hackerspace-ntnu/Coglight-badge-THT/Documentation/Figures/Pinout.png

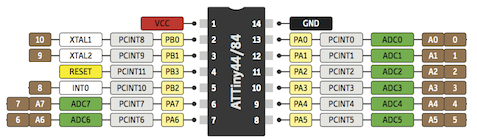
Documentation/Figures/Pinout.png
