hackerspace-ntnu/Coglight-badge-THT/Documentation/Figures/Finished.png

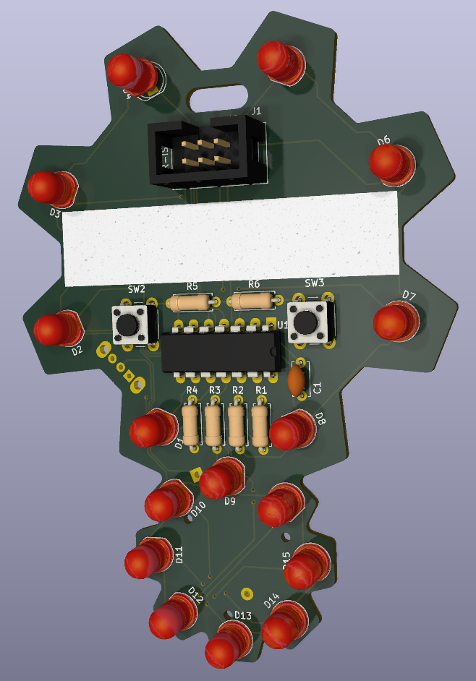
Documentation/Figures/Finished.png
