hackerspace-ntnu/Coglight-badge-THT/Documentation/Figures/Matrix.png

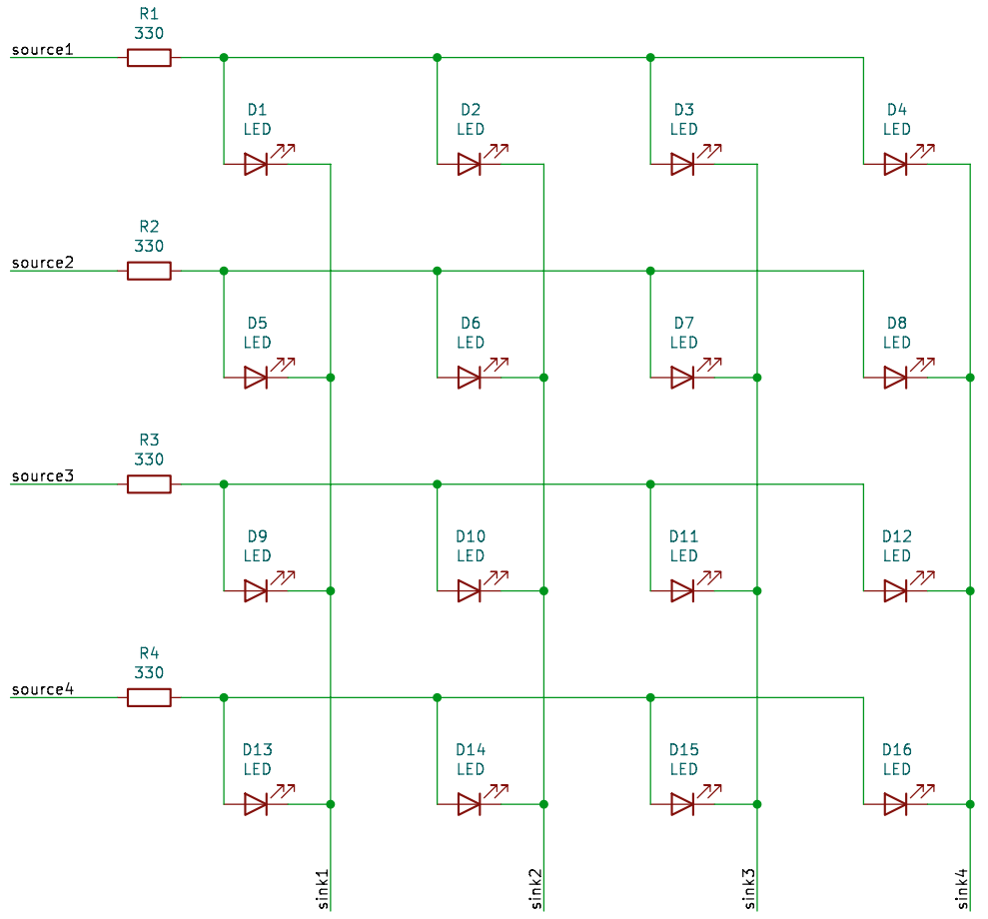
Documentation/Figures/Matrix.png
