hackerspace-ntnu/Coglight-badge-THT/Documentation/Figures/CogLightBadgeTHT.pdf

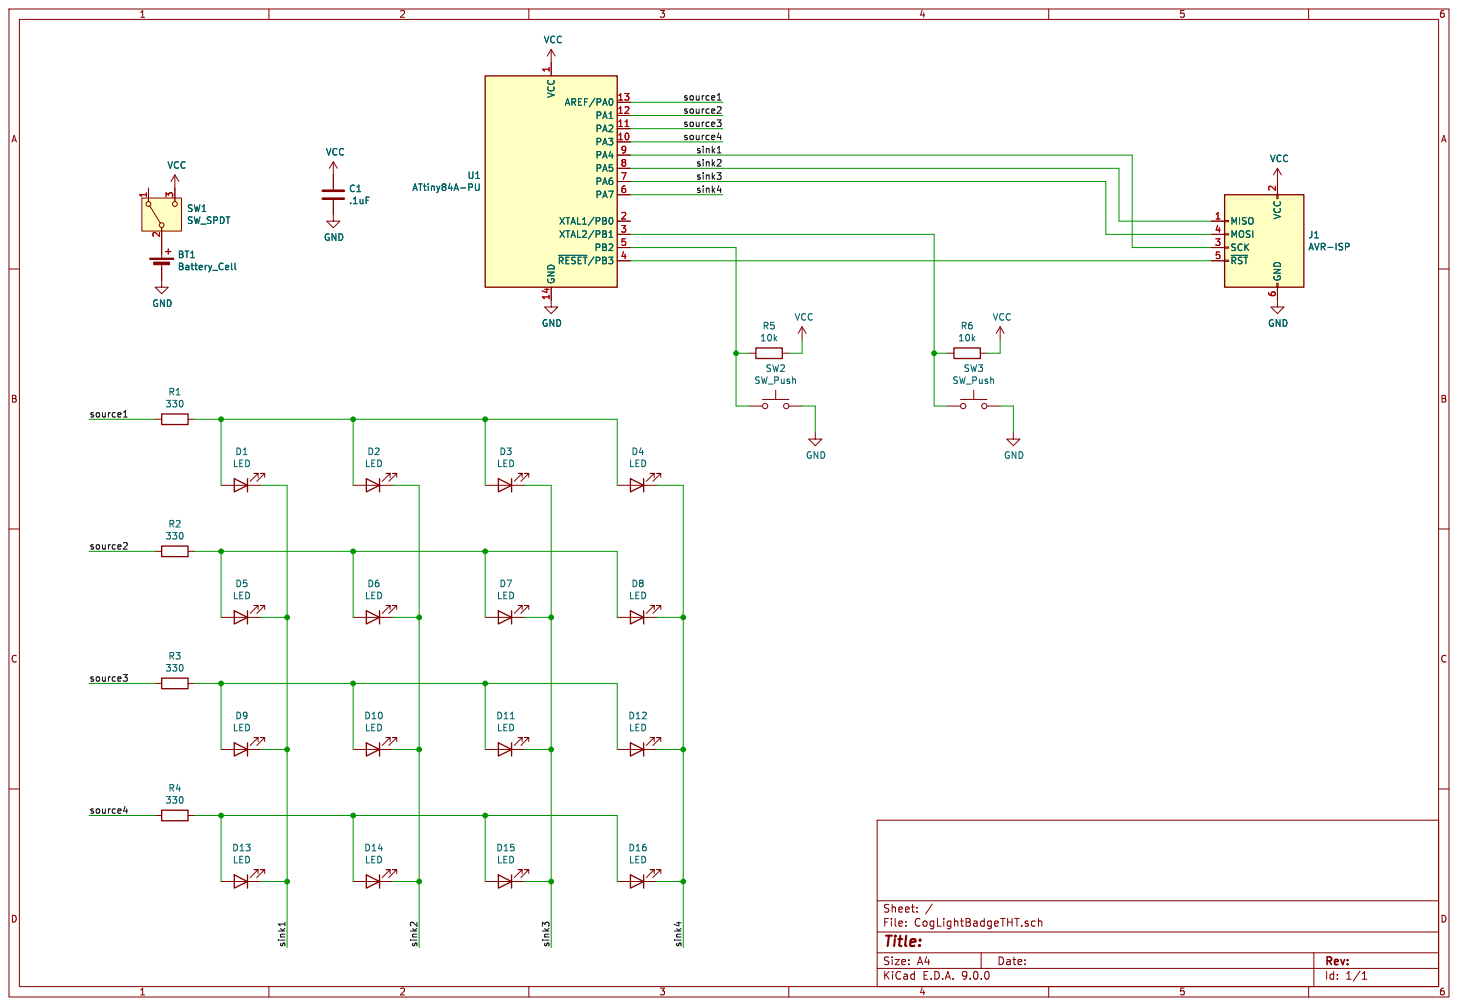
[picture p4: page 1]

1 GND 14 AREF/PA0 13 PA1 12 PA2 11 PA3 10 PA4 9 PA5 8 PA6 7 PA7 6 XTAL1/PB0 2 XTAL2/PB1 3 PB2 5 ~{RESET}/PB34 VCC GND

1 GND 14 AREF/PA0 13 PA1 12 PA2 11 PA3 10 PA4 9 PA5 8 PA6 7 PA7 6 XTAL1/PB0 2 XTAL2/PB1 3 PB2 5 ~{RESET}/PB34 U1 ATtiny84A-PU

6 MISO 1 MOSI 4 SCK 3 ~{RST} 5 VCC

6 MISO 1 MOSI 4 SCK 3 ~{RST} 5

Id: 1/1 Title: File: CogLightBadgeTHT.sch Sheet: /
