hackerspace-ntnu/Coglight-badge-THT/KiCad/CogLightBadgeTHT.kicad_pcb

## KiCad design KiCad/CogLightBadgeTHT.kicad_pcb (2025-02-27)

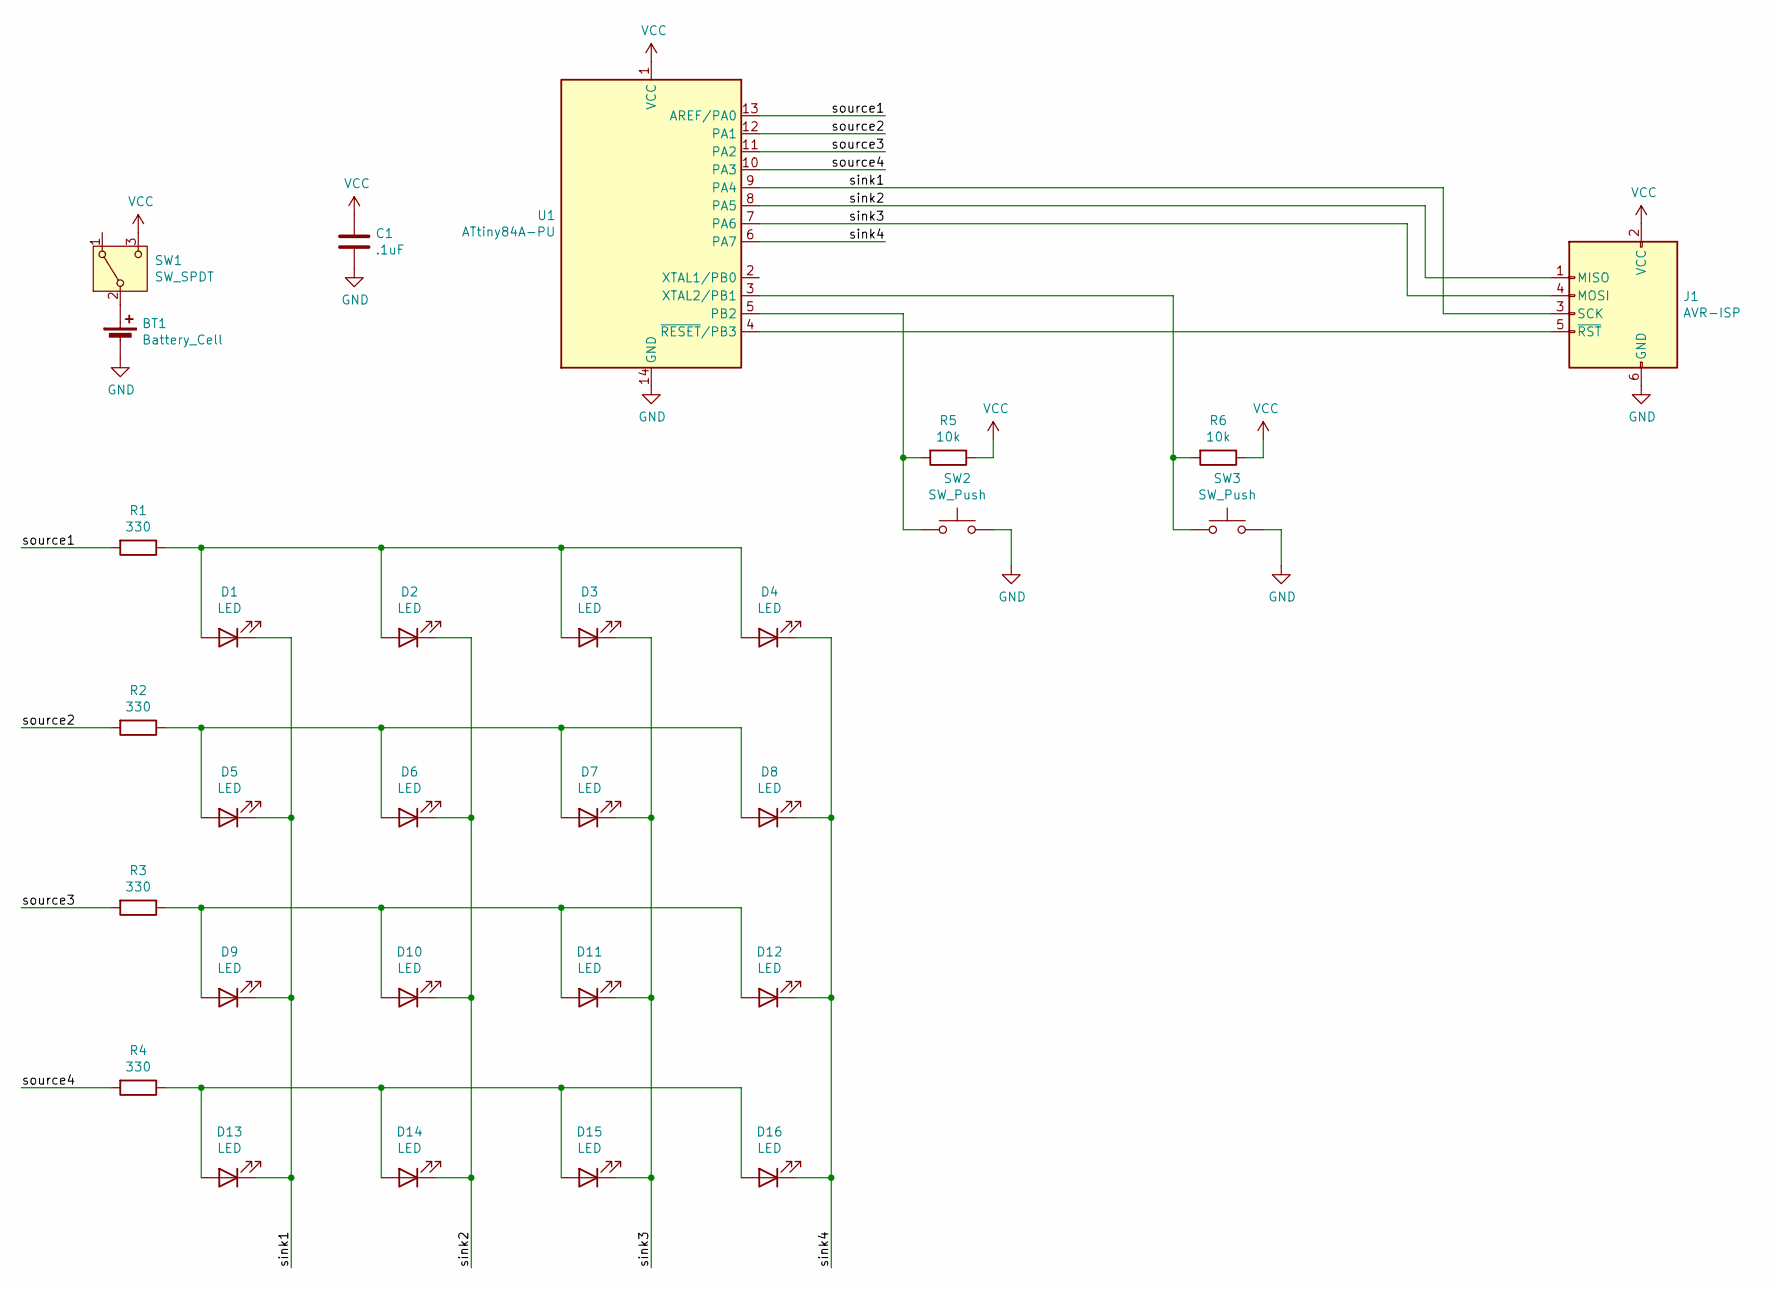
[picture p5: schematic CogLightBadgeTHT.kicad_sch]

Parts:
BT1: Battery_Cell; MP000362_CR2032_Holder_THT
C1: .1uF; C_Disc_D5.0mm_W2.5mm_P5.00mm
D1, D2, D3, D4, D5, D6, D7, D8, D9, D10, D11, D12, D13, D14, D15, D16: LED; LED_D5.0mm
J1: AVR-ISP; IDC-Header_2x03_P2.54mm_Vertical
R1, R2, R3, R4: 330; R_Axial_DIN0207_L6.3mm_D2.5mm_P7.62mm_Horizontal
R5, R6: 10k; R_Axial_DIN0207_L6.3mm_D2.5mm_P7.62mm_Horizontal
SW1: SW_SPDT; OS102011MA1QN1_SPDT_SlideSwithch_THT
SW2, SW3: SW_Push; SW_PUSH_6mm_H5mm
U1: ATtiny84A-PU; DIP-14_W7.62mm_LongPads

Connections:
/sink1: D1.1 (K), D5.1 (K), D9.1 (K), D13.1 (K), J1.3 (SCK), U1.9 (PA4)
/sink2: D2.1 (K), D6.1 (K), D10.1 (K), D14.1 (K), J1.1 (MISO), U1.8 (PA5)
/sink3: D3.1 (K), D7.1 (K), D11.1 (K), D15.1 (K), J1.4 (MOSI), U1.7 (PA6)
/sink4: D4.1 (K), D8.1 (K), D12.1 (K), D16.1 (K), U1.6 (PA7)
/source1: R1.2, U1.13 (AREF/PA0)
/source2: R2.2, U1.12 (PA1)
/source3: R3.2, U1.11 (PA2)
/source4: R4.2, U1.10 (PA3)
GND: BT1.2 (-), C1.2, J1.6 (GND), SW2.2, SW3.2, U1.14 (GND)
unnamed: BT1.1 (+), SW1.2 (B)
unnamed: D1.2 (A), D2.2 (A), D3.2 (A), D4.2 (A), R1.1
unnamed: D5.2 (A), D6.2 (A), D7.2 (A), D8.2 (A), R2.1
unnamed: D9.2 (A), D10.2 (A), D11.2 (A), D12.2 (A), R3.1
unnamed: D13.2 (A), D14.2 (A), D15.2 (A), D16.2 (A), R4.1
unnamed: J1.5 (~RST), U1.4 (~RESET/PB3)
unnamed: R5.2, SW2.1, U1.5 (PB2)
unnamed: R6.2, SW3.1, U1.3 (XTAL2/PB1)
VCC: C1.1, J1.2 (VCC), R5.1, R6.1, SW1.3 (C), U1.1 (VCC)

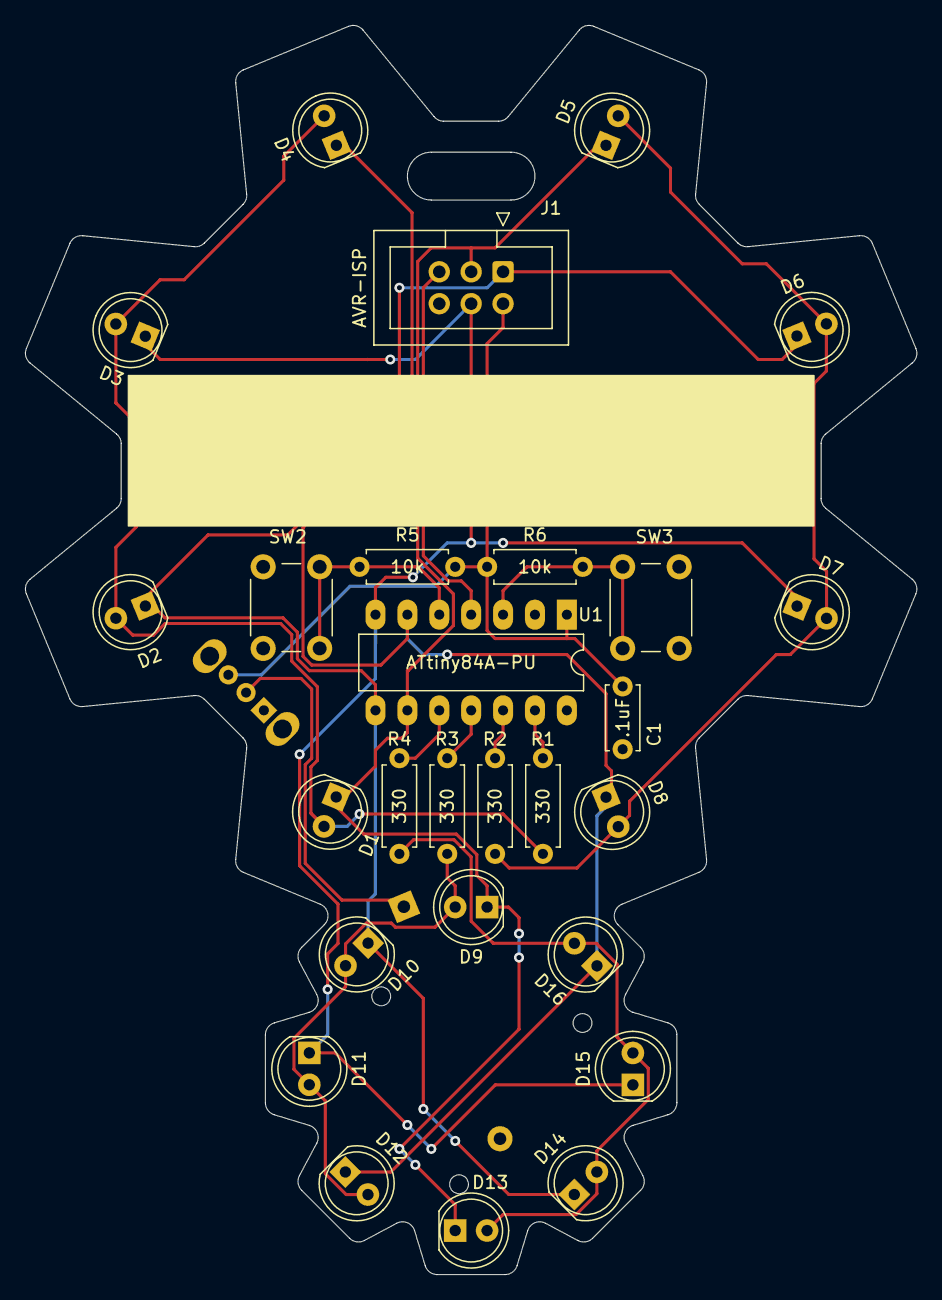
[picture p6: board CogLightBadgeTHT.kicad_pcb from above]

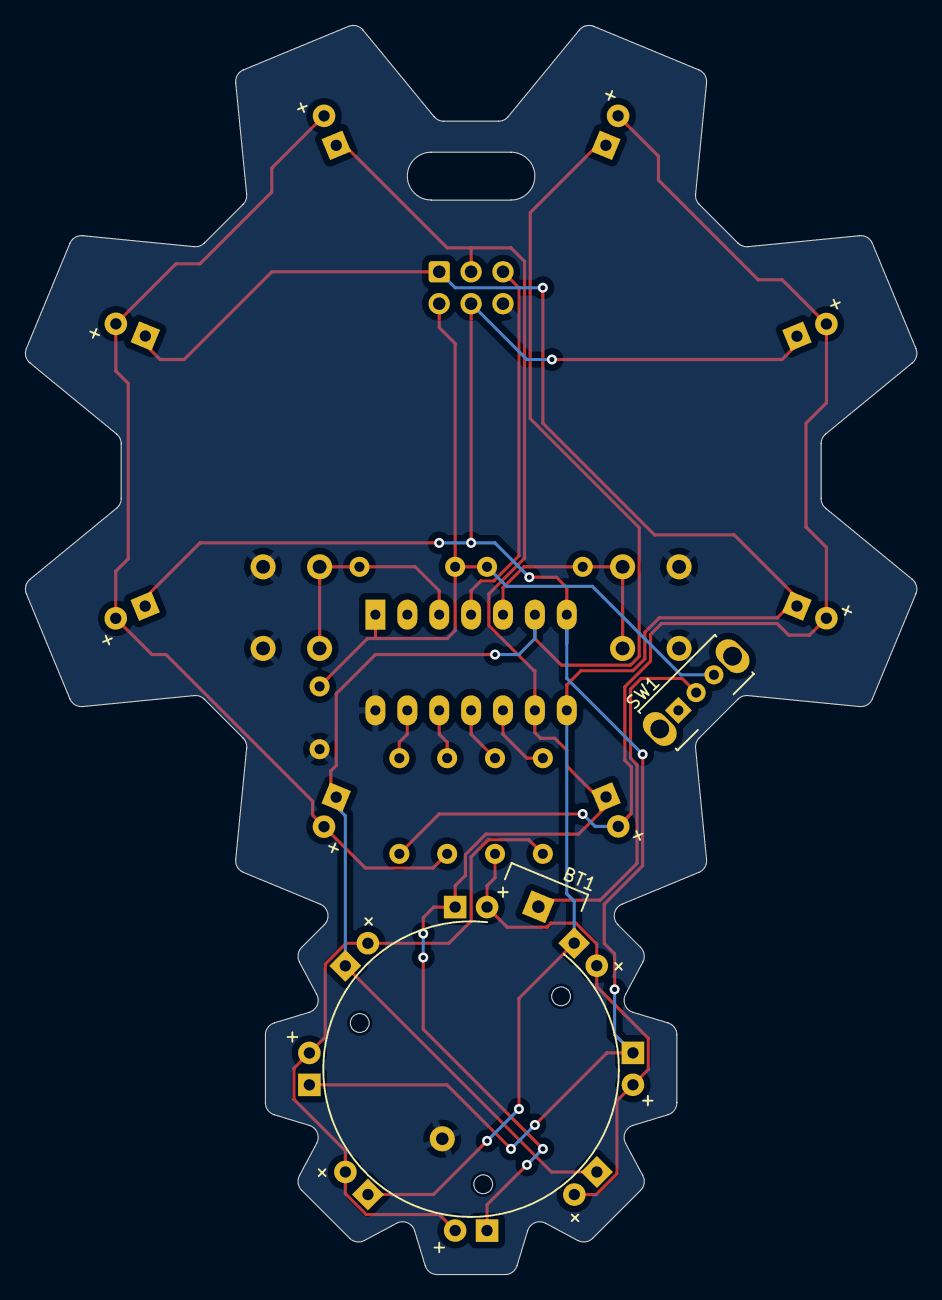
[picture p7: board CogLightBadgeTHT.kicad_pcb from below]

Board: 2 copper layers, 71.0 x 99.5 mm, 29 parts (2 on the bottom side), 18 nets.
