hackerspace-ntnu/Coglight-badge-THT/Firmware/CogBadgeArduino/CogBadgeArduino.ino

/*
 * CogBadge THT
 *
 * Original author: Benjamin
 * Adapted for Arduino IDE: Robin Pfeifer
 */ 
 

void setup() {
  DDRA = 0b11111111;	
}

//=================================//
//   Patterns                      //
//=================================//

// Pattern struct
typedef struct {
  uint8_t size; // Number of stages to the pattern to cycle through
  uint8_t stages[16]; // Patterns may have a maximum of 16 stages
} Pattern;

// Create patterns
/* See CogLightBadgeTHT.pdf for schematics. The pins read from right to left 
(source1 is farthest to the right, sink4 is farthest to the left after the b)
The sources and sinks form a matrix, where the source and sink value for each LED
combines to give the LED's value. 0 corresponds to OFF, 1 corresponds to ON. 
For example, if source1 and sink1 are both 1, D1 is 0, 
while if source1 is 1 and sink1 is 0, D1 is 1.
*/
#define patternsSIZE 9
Pattern patterns[patternsSIZE] = {
  { // Counter-clockwise 4 on at a time
    .size = 4,
    .stages = {
    0b01111111,
    0b10111111,
    0b11011111,
    0b11101111
    }
  },
  { // Clockwise 4 on at a time
	  .size = 4,
	  .stages = {
		0b01111111,
		0b11101111,
		0b11011111,
		0b10111111
	  }
  },
  { // Counter-clockwise 4 pairs (8 LEDs) on at a time
	  .size = 4,
	  .stages = {
		0b00111111,
		0b10011111,
		0b11001111,
		0b01101111
	  }
  },
  { // Clockwise 4 pairs (8 LEDs) on at a time
	  .size = 4,
	  .stages = {
		0b00111111,
		0b01101111,
		0b11001111,
		0b10011111
	  }
	},
  { // Every other LED on, alternating which ones
	  .size = 2,
	  .stages = {
		0b01011111,
		0b10101111
	  }
	},
  { // All LEDs on, then off
	  .size = 2,
	  .stages = {
		0b00001111,
		0b11111111
	  }
	},
  { // All LEDs on
	  .size = 1,
	  .stages = {
		0b00001111
	  }
	},
  { // Counter-clockwise 1 on at a time
	  .size = 16,
	  .stages = {
		0b11100001,
		0b01111000,
		0b10111000,
		0b11011000,
		0b11101000,
		0b01110100,
		0b10110100,
		0b11010100,
		0b11100100,
		0b01110010,
		0b10110010,
		0b11010010,
		0b11100010,
		0b01110001,
		0b10110001,
		0b11010001
	  }
	},
  { // Clockwise 1 on at a time
	  .size = 16,
	  .stages = {
		0b11100001,
		0b11010001,
		0b10110001,
		0b01110001,
		0b11100010,
		0b11010010,
		0b10110010,
		0b01110010,
		0b11100100,
		0b11010100,
		0b10110100,
		0b01110100,
		0b11101000,
		0b11011000,
		0b10111000,
		0b01111000
	  }
  }
};

//=================================//
//   IMPL                          //
//=================================//

bool bitChangeLow(uint8_t newVal, uint8_t oldVal, uint8_t bit) {
  bit = 1<<bit;
  return ((newVal & bit) != (oldVal & bit)) && (newVal & bit) == 0;
}

// Debounce buttons with four samples
uint8_t pinb[4];
uint8_t debouncedPINB() {
  for (int i = 3; i > 0; i--) {
    pinb[i] = pinb[i-1];
  }
  pinb[0] = PINB;

  return pinb[0] & pinb[1] & pinb[2] & pinb[3];
}

// Update and step through patterns
uint8_t currentPattern = 0;
uint8_t lastPattern = 0;
uint8_t nextStage = 0;
void stepPattern() {
  if (currentPattern != lastPattern) {
    lastPattern = currentPattern;
    nextStage = 0;
  }

  PORTA = patterns[currentPattern].stages[nextStage++];

  if (nextStage >= patterns[currentPattern].size) {
    nextStage = 0;
  }
}

int patternStageTime = 20; // Time between pattern stages in multiples of x10ms
uint8_t currentPatternTime = 0;	// Time spent so far on the current stage
uint8_t previousPINB = debouncedPINB(); // Used for detecting button state change
void loop() {

  // Check buttons
  uint8_t currentPINB = debouncedPINB();
  if (bitChangeLow(currentPINB, previousPINB, PINB1)) {
    // Button SW3 changes pattern step time
    patternStageTime *= 2; // Double step time each time
    if (patternStageTime > 160) {
    // Cycle back to a step time of 50ms after 1600ms
    patternStageTime = 5;
    }
  }
  else if (bitChangeLow(currentPINB, previousPINB, PINB2)) {
	  // Button SW2 changes pattern
	  currentPattern++;
	  currentPatternTime = patternStageTime; // Fast forward time for immediate pattern change
	  if (currentPattern >= patternsSIZE) {
		currentPattern = 0;
	  }
	}
  previousPINB = currentPINB; // Update memory of button state

	// Increment pattern time
	if (++currentPatternTime >= patternStageTime) {
	  stepPattern();
	  currentPatternTime = 0;
	}
  // Sleep for 10ms
	delay(10);
}
