hackerspace-ntnu/Coglight-badge-THT/(commit log)

2021-10-18 Only mark + for LED polarity
    [CogLightBadgeTHT.kicad_pcb]
2022-03-19 Reorganize project and add firmware
    [CogLightBadgeTHT.kicad_pcb, CogLightBadgeTHT.sch]
2025-02-27 Updated gerber files, wrote short documentation
    [CogLightBadgeTHT-B_Cu.gbr, CogLightBadgeTHT-B_Mask.gbr, CogLightBadgeTHT-B_Paste.gbr, CogLightBadgeTHT-B_SilkS.gbr, CogLightBadgeTHT-Edge_Cuts.gbr, CogLightBadgeTHT-F_Cu.gbr, CogLightBadgeTHT-F_Mask.gbr, CogLightBadgeTHT-F_Paste.gbr]
2025-02-28 Moved arduino firmware to own folder, preserving atmel-speciffic code
